KeiranCantilina/Carillon-Soft-Register/README.md

# Carillon-Soft-Register
The design of a "soft register" for the carillon
