KeiranCantilina/Carillon-Soft-Register/(list of files, cad)

Other CAD files:
CarillonSoftRegister.dwg
