KeiranCantilina/Carillon-Soft-Register/CarillonSoftRegister_drawing_pdf.pdf

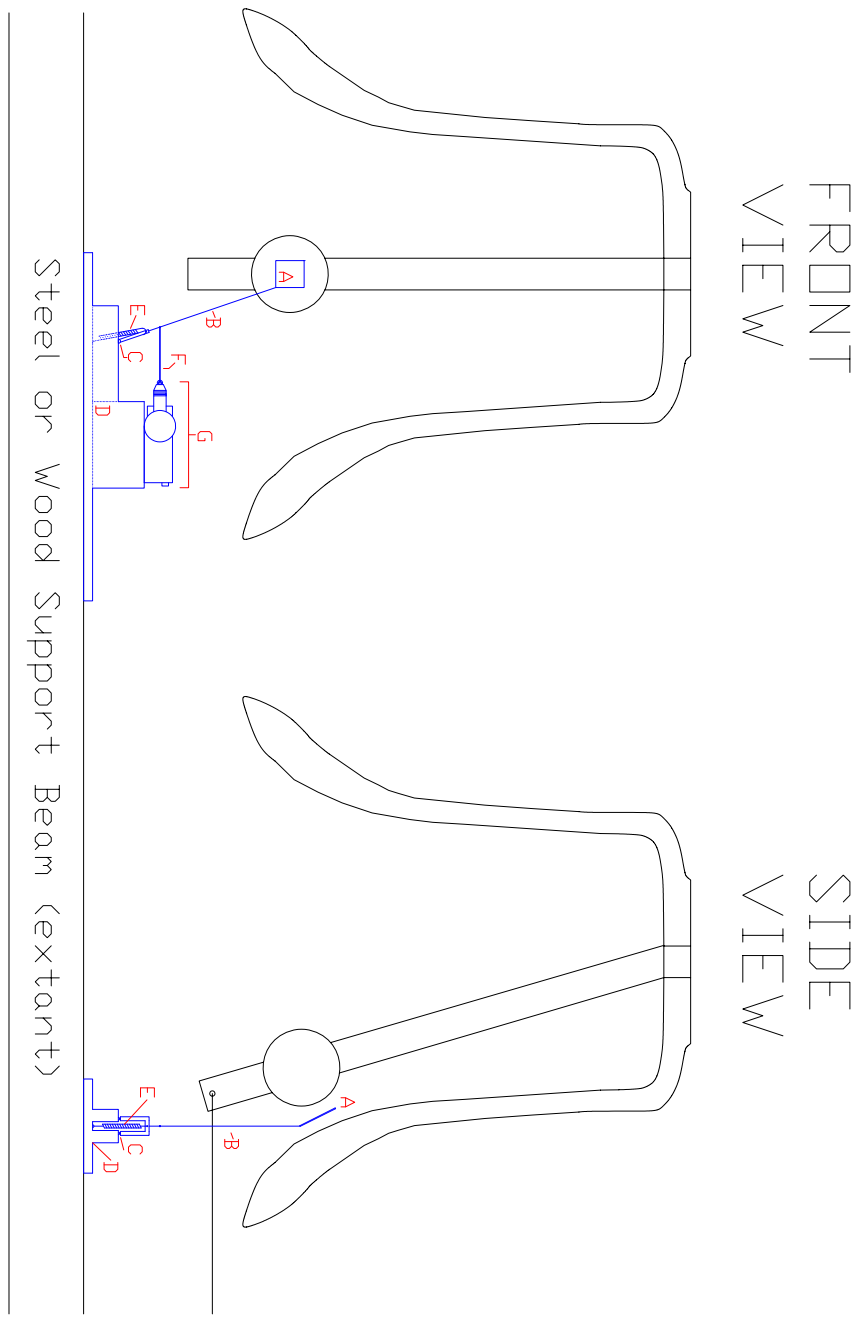
[picture p3: page 1]
