KeiranCantilina/Carillon-Soft-Register/CarillonSoftPedal_wiring diagram.pptx

Notes for Relay Blocks:
Coil connections are at the top and bottom of the block, terminals are to the sides of the block.

Actuator

Terminal Block (A)

+ Relay (Extension)

Actuator

Terminal Block (B)

- Relay (Extension)

ON button

Actuator

Actuator

- Relay (Retraction)

Actuator

+ Relay (Retraction)

OFF button

Etc.

+ 12V Battery --

Carillon Soft Register Wiring Diagram
