KeiranCantilina/Carillon-Soft-Register/(commit log)

2018-08-05 Updated files, added budget
    [Budget_HackTheBells.xlsx]
2018-08-05 Fixed minor errors
    [Budget_HackTheBells.xlsx]
2018-08-06 First draft
    [CarillonSoftRegister.dwg]
2018-08-06 Updates (Draft 1)
    [Budget_HackTheBells.xlsx]
2018-08-06 Added wiring diagram files
2018-08-06 Changed color layout, added wiring diagram
